worksharder996/watercolorbot-revival/sources/primary-sources.md

# Primary source index

Research date: 2026-11-08.

## Original WaterColorBot

- Main wiki: https://wiki.evilmadscientist.com/WaterColorBot
- Hardware reference design: https://wiki.evilmadscientist.com/WaterColorBot_Reference_Design
- Software overview: https://wiki.evilmadscientist.com/WaterColorBot_Software
- Inkscape workflow: https://wiki.evilmadscientist.com/Inkscape_and_WaterColorBot
- RoboPaint: https://wiki.evilmadscientist.com/RoboPaint
- RoboPaint RT: https://wiki.evilmadscientist.com/RoboPaint_RT
- Troubleshooting: https://wiki.evilmadscientist.com/WaterColorBot_Troubleshooting
- Paper: https://wiki.evilmadscientist.com/WaterColorBot_Paper
- Paints: https://wiki.evilmadscientist.com/WaterColorBot_Paints
- Writing implements: https://wiki.evilmadscientist.com/WaterColorBot_Writing_Implements

## Controller

- EBB main page: https://www.schmalzhaus.com/EBB/
- Current EBB commands: https://evil-mad.github.io/EggBot/ebb.html
- Legacy EBB 2.x commands: https://evil-mad.github.io/EggBot/ebb2.html
- EBB release notes: https://evil-mad.github.io/EggBot/EBBReleaseNotes.html
- EggBot/EBB firmware source: https://github.com/evil-mad/EggBot
- SparkFun EBB hardware: https://github.com/sparkfun/EiBotBoard

## Software

- wcb-ink: https://github.com/evil-mad/wcb-ink
- plotink: https://github.com/evil-mad/plotink
- RoboPaint: https://github.com/evil-mad/robopaint
- RoboPaint RT: https://github.com/evil-mad/robopaint-rt
- WaterColorBlocks: https://github.com/evil-mad/WaterColorBlocks
- CNCServer: https://github.com/techninja/cncserver
- CNCServer REST API: https://github.com/techninja/cncserver/blob/master/API.md
- Scratch API: https://github.com/techninja/cncserver/blob/master/scratch/SCRATCH.API.md
- RoboPaint remote-print API: https://github.com/evil-mad/robopaint-mode-remote/blob/master/API.md

## Current commercial reference

- Bantam Tools WaterColorBot: https://bantamtools.com/products/bantam-tools-watercolorbot
- Evil Mad Scientist/AxiDraw history: https://content.bantamtools.com/blog/a-look-back-part-2

## Integrity manifests

See the JSON and TSV files in this directory for downloaded-file hashes, retrieval timestamps, license scans, and fork results.
