worksharder996/watercolorbot-revival/hardware/reference-designs/v1/wcb_refdesign/readme.txt

Eggbot 2.0 refrence design.

The files here are:

* Bill of materials, CSV format
* 1/4" plywood chassis and pen-arm parts, Inkscape SVG
* 1/4" Poplar pen-arm part, Inkscape SVG
* 1/2" plywood parts
* 0.020" delrin part, Inkscape SVG
* 0.010" acetal copolymer, Inkscape SVG
