worksharder996/watercolorbot-revival/hardware/reference-designs/v2/WCBv2.0_r1/Solidworks/Winch3.SLDPRT

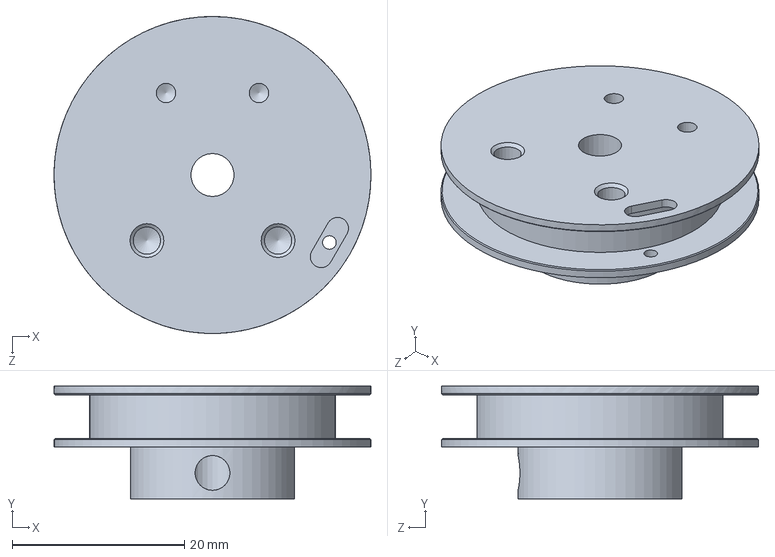
[picture p2: CAD file, 2026-11-08]
hardware/reference-designs/v2/WCBv2.0_r1/Solidworks/Winch3.SLDPRT
36.8 x 13.1 x 36.8 mm
