worksharder996/watercolorbot-revival/hardware/reference-designs/v2/WCBv2.0_r1/Solidworks/WCB-brushmount.SLDPRT

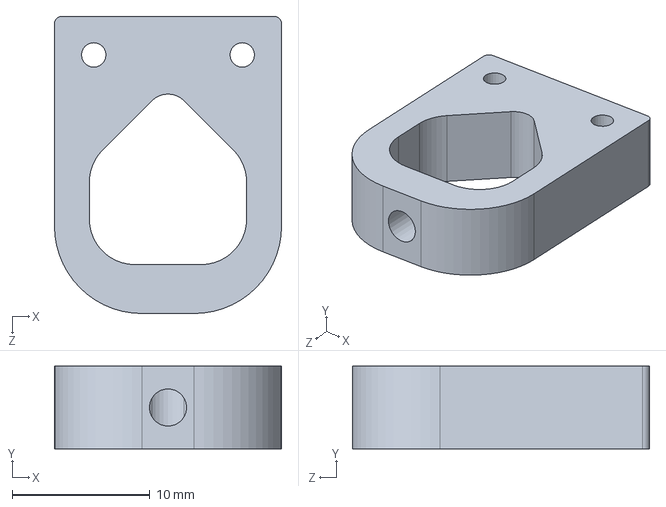
[picture p3: CAD file, 2026-11-08]
hardware/reference-designs/v2/WCBv2.0_r1/Solidworks/WCB-brushmount.SLDPRT
16.5 x 6.00 x 21.6 mm
