worksharder996/watercolorbot-revival/hardware/reference-designs/v2/WCBv2.0_r1/Solidworks/WCBC Bearing Mount.SLDPRT

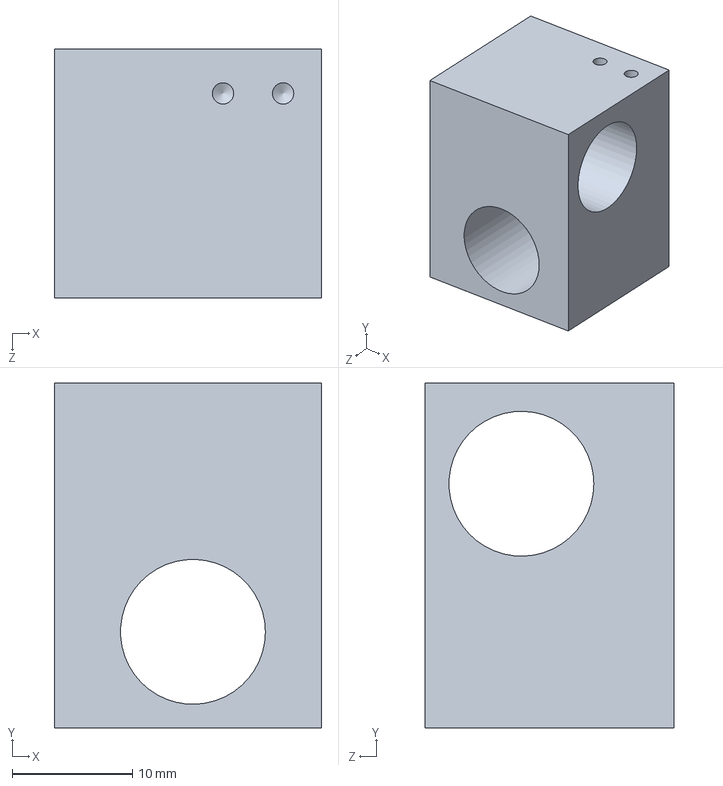
[picture p4: CAD file, 2026-11-08]
hardware/reference-designs/v2/WCBv2.0_r1/Solidworks/WCBC Bearing Mount.SLDPRT
22.2 x 28.7 x 20.7 mm
