worksharder996/watercolorbot-revival/hardware/reference-designs/v2/WCBv2.0_r1/Solidworks/shaft_6mm_long.SLDPRT

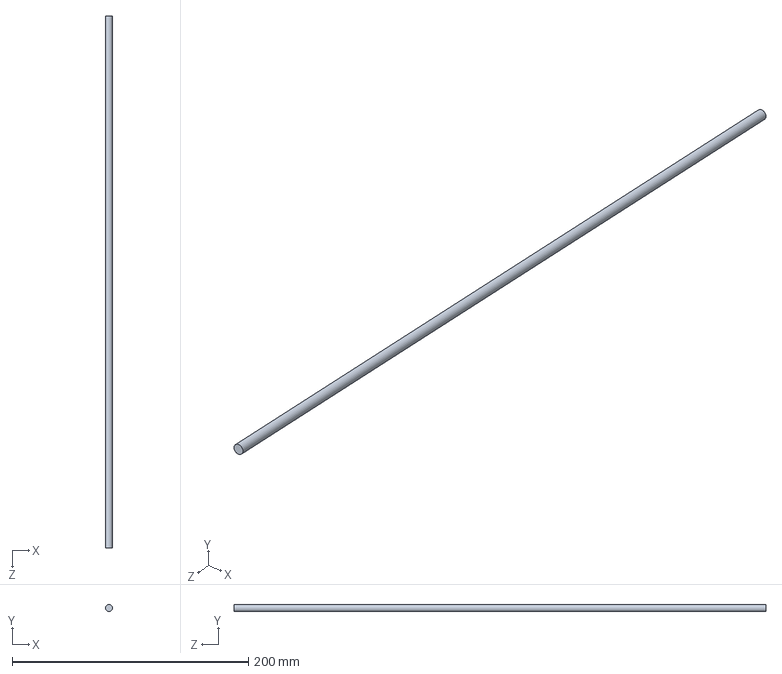
[picture p5: CAD file, 2026-11-08]
hardware/reference-designs/v2/WCBv2.0_r1/Solidworks/shaft_6mm_long.SLDPRT
6.00 x 6.00 x 450.0 mm
