worksharder996/watercolorbot-revival/hardware/reference-designs/v2/WCBv2.0_r1/Solidworks/Vertical Strut SM4.SLDPRT

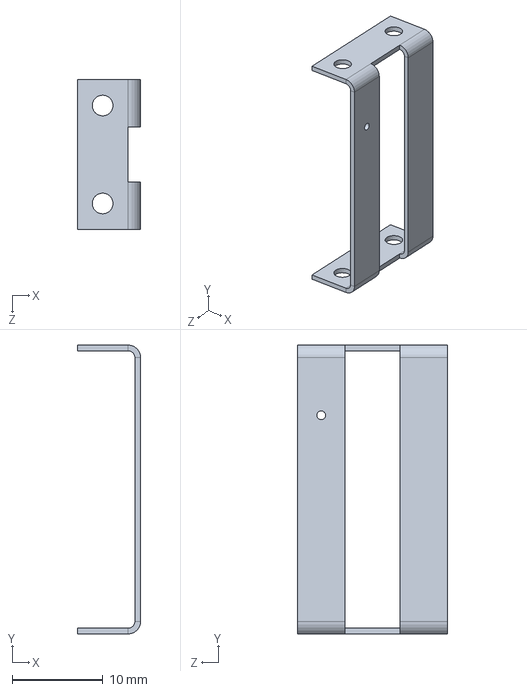
[picture p6: CAD file, 2026-11-08]
hardware/reference-designs/v2/WCBv2.0_r1/Solidworks/Vertical Strut SM4.SLDPRT
6.98 x 31.8 x 16.5 mm
