worksharder996/watercolorbot-revival/hardware/reference-designs/v2/WCBv2.0_r1/Solidworks/Carriage WrapPlate7.SLDPRT

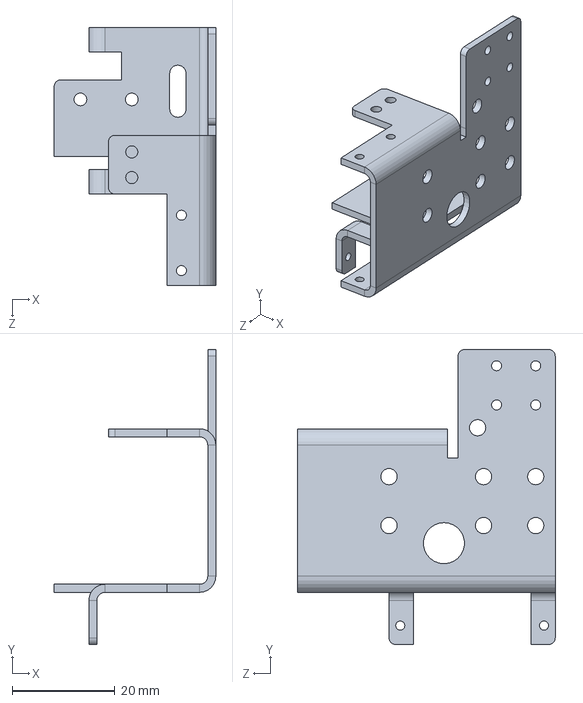
[picture p7: CAD file, 2026-11-08]
hardware/reference-designs/v2/WCBv2.0_r1/Solidworks/Carriage WrapPlate7.SLDPRT
31.5 x 57.5 x 50.2 mm
