worksharder996/watercolorbot-revival/hardware/reference-designs/v2/WCBv2.0_r1/Solidworks/WCB Hinge Washer.SLDPRT

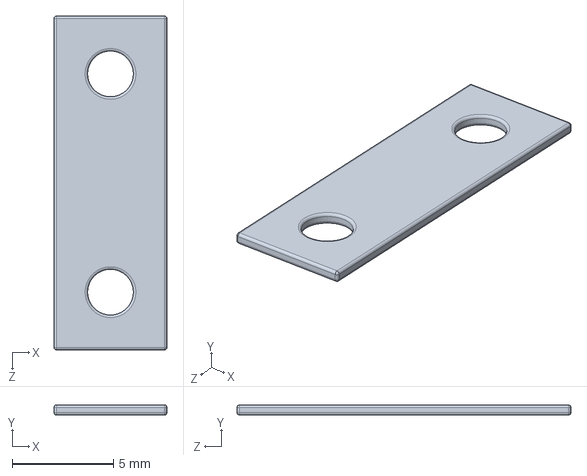
[picture p8: CAD file, 2026-11-08]
hardware/reference-designs/v2/WCBv2.0_r1/Solidworks/WCB Hinge Washer.SLDPRT
5.59 x 0.508 x 16.5 mm
