worksharder996/watercolorbot-revival/hardware/reference-designs/v2/WCBv2.0_r1/Solidworks/WCB_WINCH_BASE_61-0094A.PDF

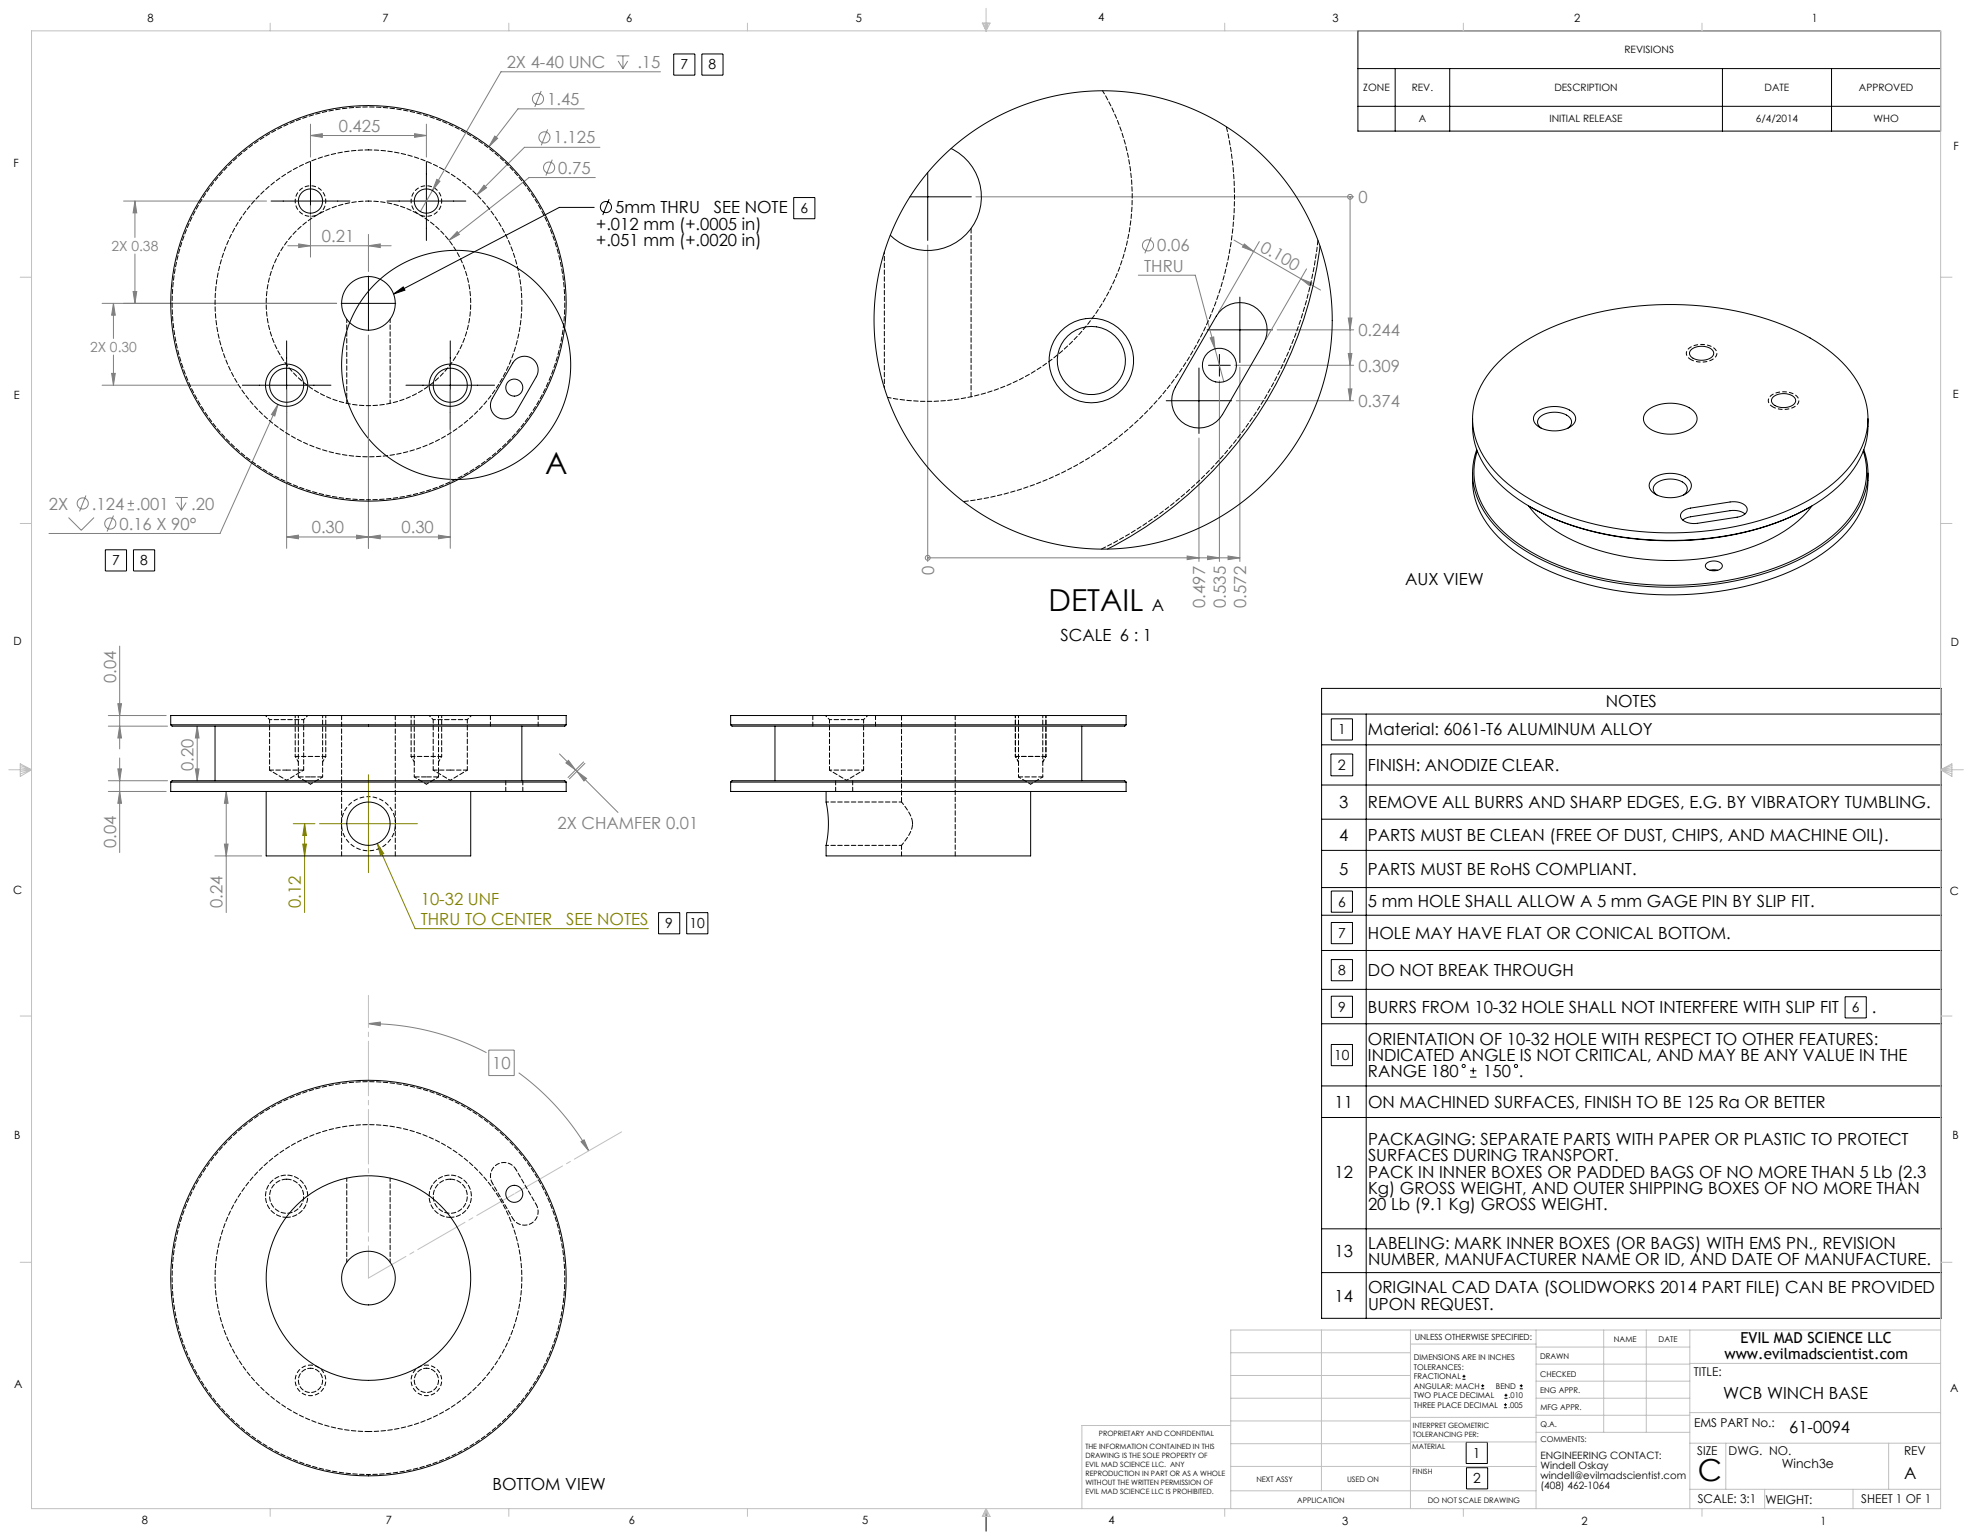
[picture p208: page 1]
2X CHAMFER 0.01; 2X 4-40 UNC; 5mm THRU SEE NOTE; AUX VIEW; DETAIL A; SCALE 6 : 1; BOTTOM VIEW; Material: 6061-T6 ALUMINUM ALLOY; FINISH: ANODIZE CLEAR.; HOLE MAY HAVE FLAT OR CONICAL BOTTOM.; DO NOT BREAK THROUGH; BURRS FROM 10-32 HOLE SHALL NOT INTERFERE WITH SLIP FIT; RANGE 180; SHEET 1 OF 1; SCALE: 3:1 WEIGHT:; DWG. NO.; REV; MFG APPR.; ENG APPR.; INTERPRET GEOMETRIC TOLERANCING PER:; ANGULAR: MACH; BEND; TWO PLACE DECIMAL; NEXT ASSY; USED ON; ENGINEERING CONTACT: Windell Oskay (408) 462-1064

ZONE | REV. | DESCRIPTION | DATE | APPROVED

A | INITIAL RELEASE | 6/4/2014 | WHO

3 | REMOVE ALL BURRS AND SHARP EDGES, E.G. BY VIBRATORY TUMBLING.
4 | PARTS MUST BE CLEAN (FREE OF DUST, CHIPS, AND MACHINE OIL).
5 | PARTS MUST BE RoHS COMPLIANT.
6 | 5 mm HOLE SHALL ALLOW A 5 mm GAGE PIN BY SLIP FIT.

10-32 UNF
THRU TO CENTER SEE NOTES

ORIENTATION OF 10-32 HOLE WITH RESPECT TO OTHER FEATURES: INDICATED ANGLE IS NOT CRITICAL, AND MAY BE ANY VALUE IN THE

11 | ON MACHINED SURFACES, FINISH TO BE 125 Ra OR BETTER
12 | PACKAGING: SEPARATE PARTS WITH PAPER OR PLASTIC TO PROTECT SURFACES DURING TRANSPORT. PACK IN INNER BOXES OR PADDED BAGS OF NO MORE THAN 5 Lb (2.3 Kg) GROSS WEIGHT, AND OUTER SHIPPING BOXES OF NO MORE THAN 20 Lb (9.1 Kg) GROSS WEIGHT.

13 | LABELING: MARK INNER BOXES (OR BAGS) WITH EMS PN., REVISION NUMBER, MANUFACTURER NAME OR ID, AND DATE OF MANUFACTURE.

14 | ORIGINAL CAD DATA (SOLIDWORKS 2014 PART FILE) CAN BE PROVIDED UPON REQUEST.

EVIL MAD SCIENCE LLC
www.evilmadscientist.com
TITLE:
WCB WINCH BASE

UNLESS OTHERWISE SPECIFIED:

DIMENSIONS ARE IN INCHES
TOLERANCES:
FRACTIONAL
THREE PLACE DECIMAL .005

EMS PART No.:
SIZE

PROPRIETARY AND CONFIDENTIAL
THE INFORMATION CONTAINED IN THIS
DRAWING IS THE SOLE PROPERTY OF
EVIL MAD SCIENCE LLC. ANY
REPRODUCTION IN PART OR AS A WHOLE
WITHOUT THE WRITTEN PERMISSION OF
EVIL MAD SCIENCE LLC IS PROHIBITED.

DO NOT SCALE DRAWING
