worksharder996/watercolorbot-revival/hardware/reference-designs/v2/WCBv2.0_r1/Solidworks/WCBC BearingMount.PDF

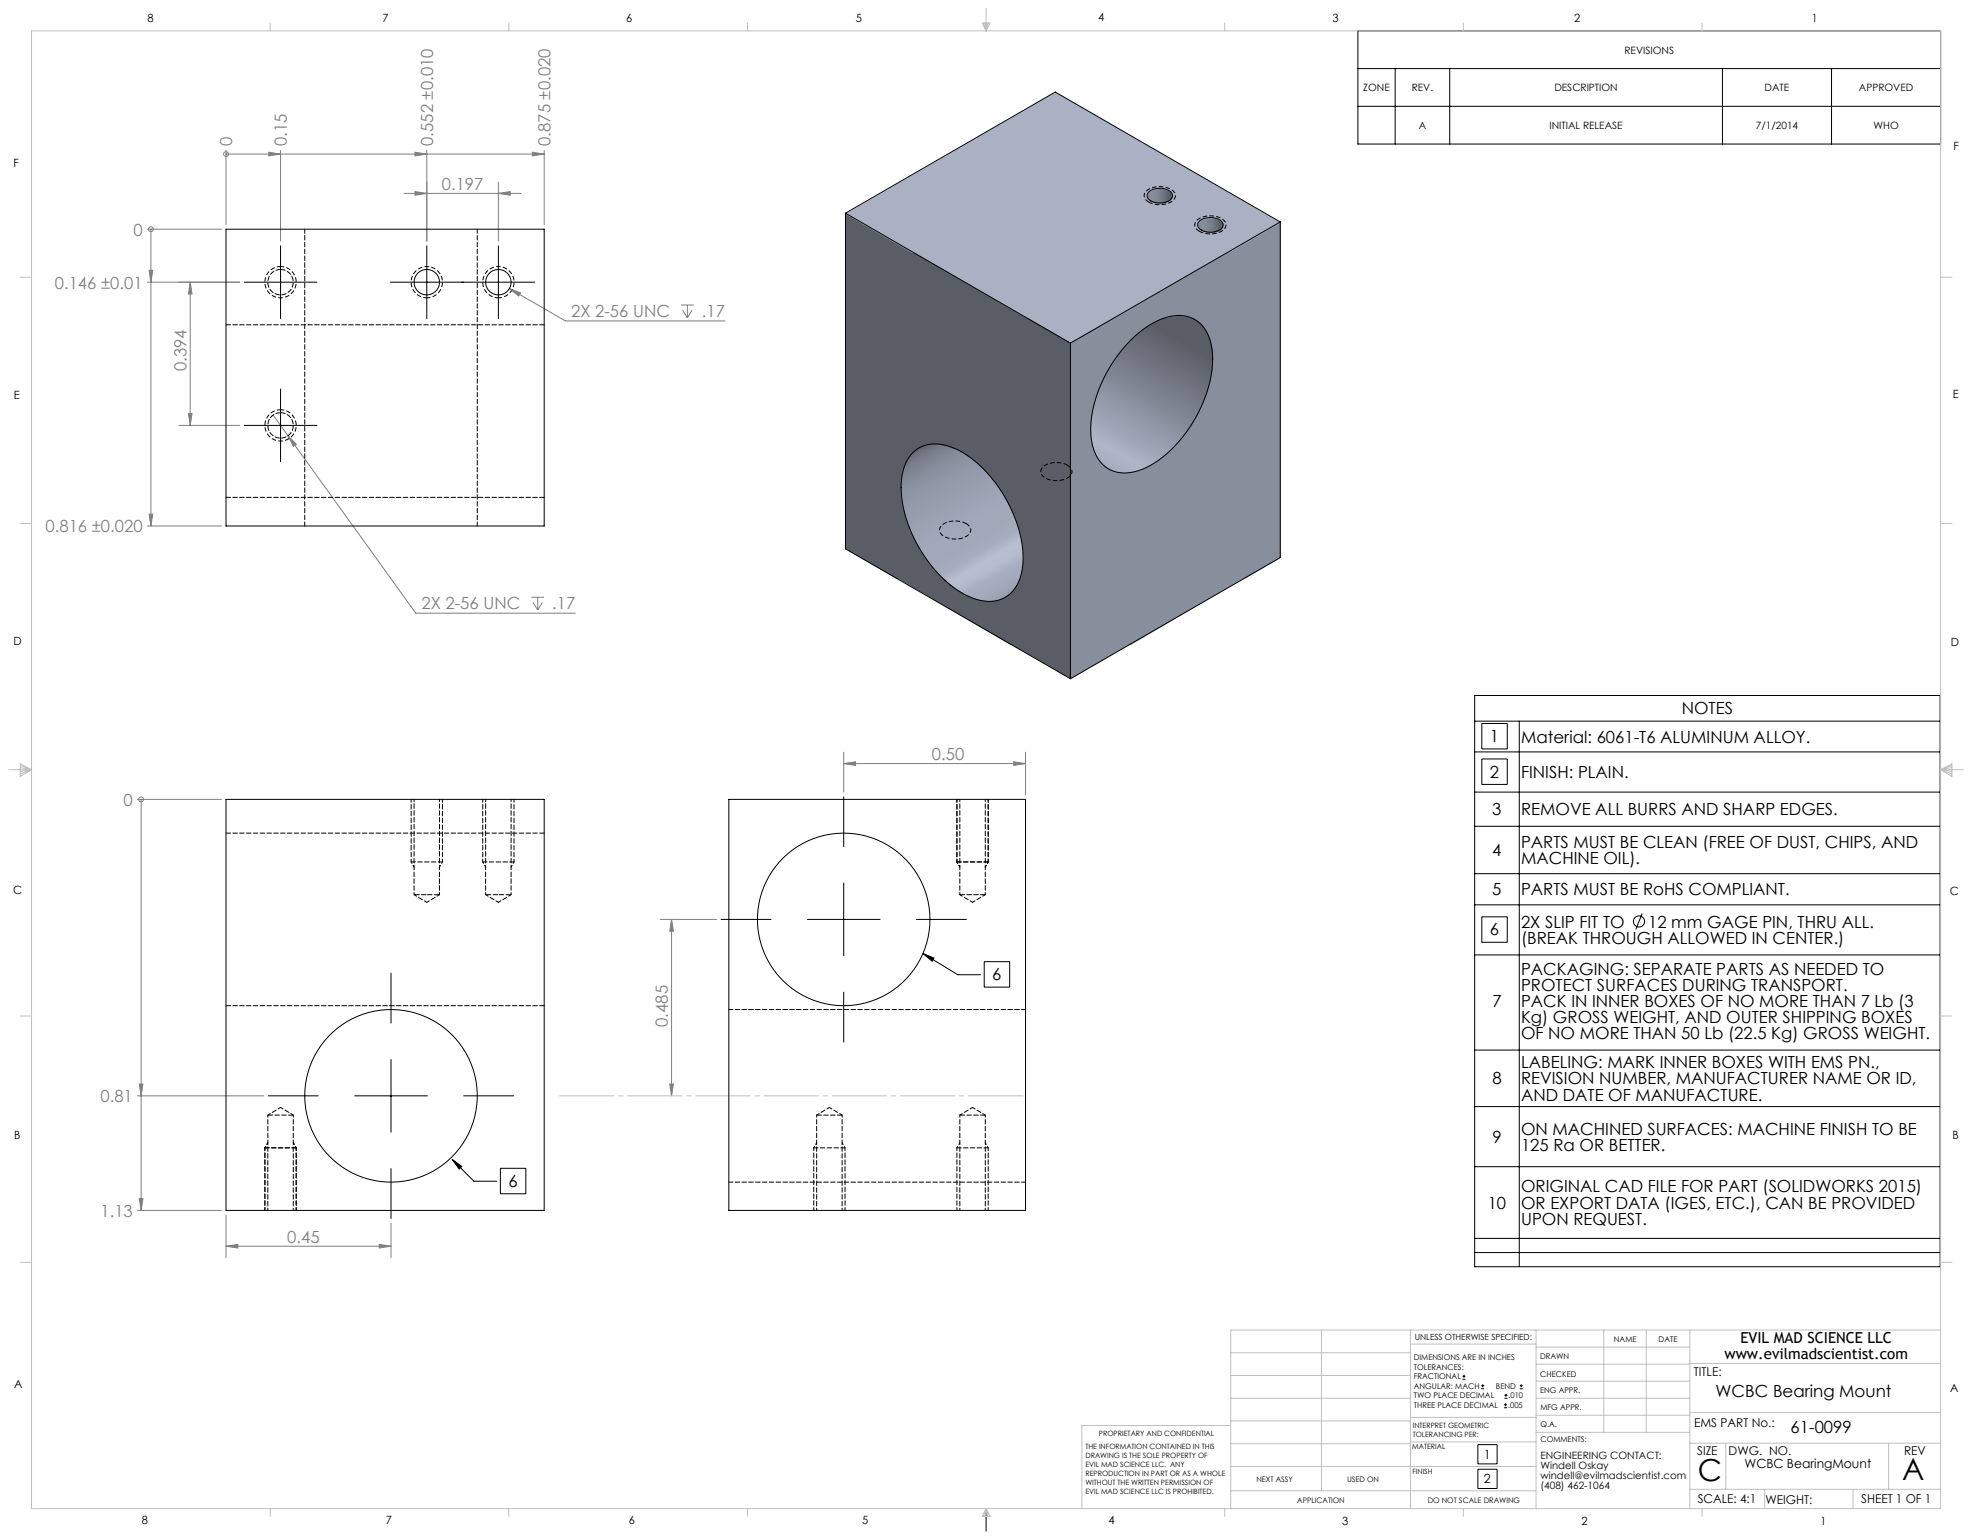
[picture p209: page 1]
2X 2-56 UNC; Material: 6061-T6 ALUMINUM ALLOY.; FINISH: PLAIN.; 2X SLIP FIT TO 12 mm GAGE PIN, THRU ALL.; SHEET 1 OF 1; SCALE: 4:1 WEIGHT:; DWG. NO.; REV; MFG APPR.; ENG APPR.; INTERPRET GEOMETRIC TOLERANCING PER:; ANGULAR: MACH; BEND; TWO PLACE DECIMAL; NEXT ASSY; USED ON; ENGINEERING CONTACT: Windell Oskay (408) 462-1064

ZONE | REV. | DESCRIPTION | DATE | APPROVED

A | INITIAL RELEASE | 7/1/2014 | WHO

3 | REMOVE ALL BURRS AND SHARP EDGES.
4 | PARTS MUST BE CLEAN (FREE OF DUST, CHIPS, AND MACHINE OIL).

5 | PARTS MUST BE RoHS COMPLIANT.

(BREAK THROUGH ALLOWED IN CENTER.)

7 | PACKAGING: SEPARATE PARTS AS NEEDED TO PROTECT SURFACES DURING TRANSPORT. PACK IN INNER BOXES OF NO MORE THAN 7 Lb (3 Kg) GROSS WEIGHT, AND OUTER SHIPPING BOXES OF NO MORE THAN 50 Lb (22.5 Kg) GROSS WEIGHT.

8 | LABELING: MARK INNER BOXES WITH EMS PN., REVISION NUMBER, MANUFACTURER NAME OR ID, AND DATE OF MANUFACTURE.

9 | ON MACHINED SURFACES: MACHINE FINISH TO BE 125 Ra OR BETTER.

ORIGINAL CAD FILE FOR PART (SOLIDWORKS 2015)
UPON REQUEST.

OR EXPORT DATA (IGES, ETC.), CAN BE PROVIDED

EVIL MAD SCIENCE LLC
www.evilmadscientist.com
TITLE:
WCBC Bearing Mount
WCBC BearingMount

UNLESS OTHERWISE SPECIFIED:

DIMENSIONS ARE IN INCHES
TOLERANCES:
FRACTIONAL
THREE PLACE DECIMAL .005

EMS PART No.:
SIZE

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

DO NOT SCALE DRAWING
