worksharder996/watercolorbot-revival/hardware/reference-designs/v2/WCBv2.0_r1/Solidworks/WCBC BrushMount.PDF

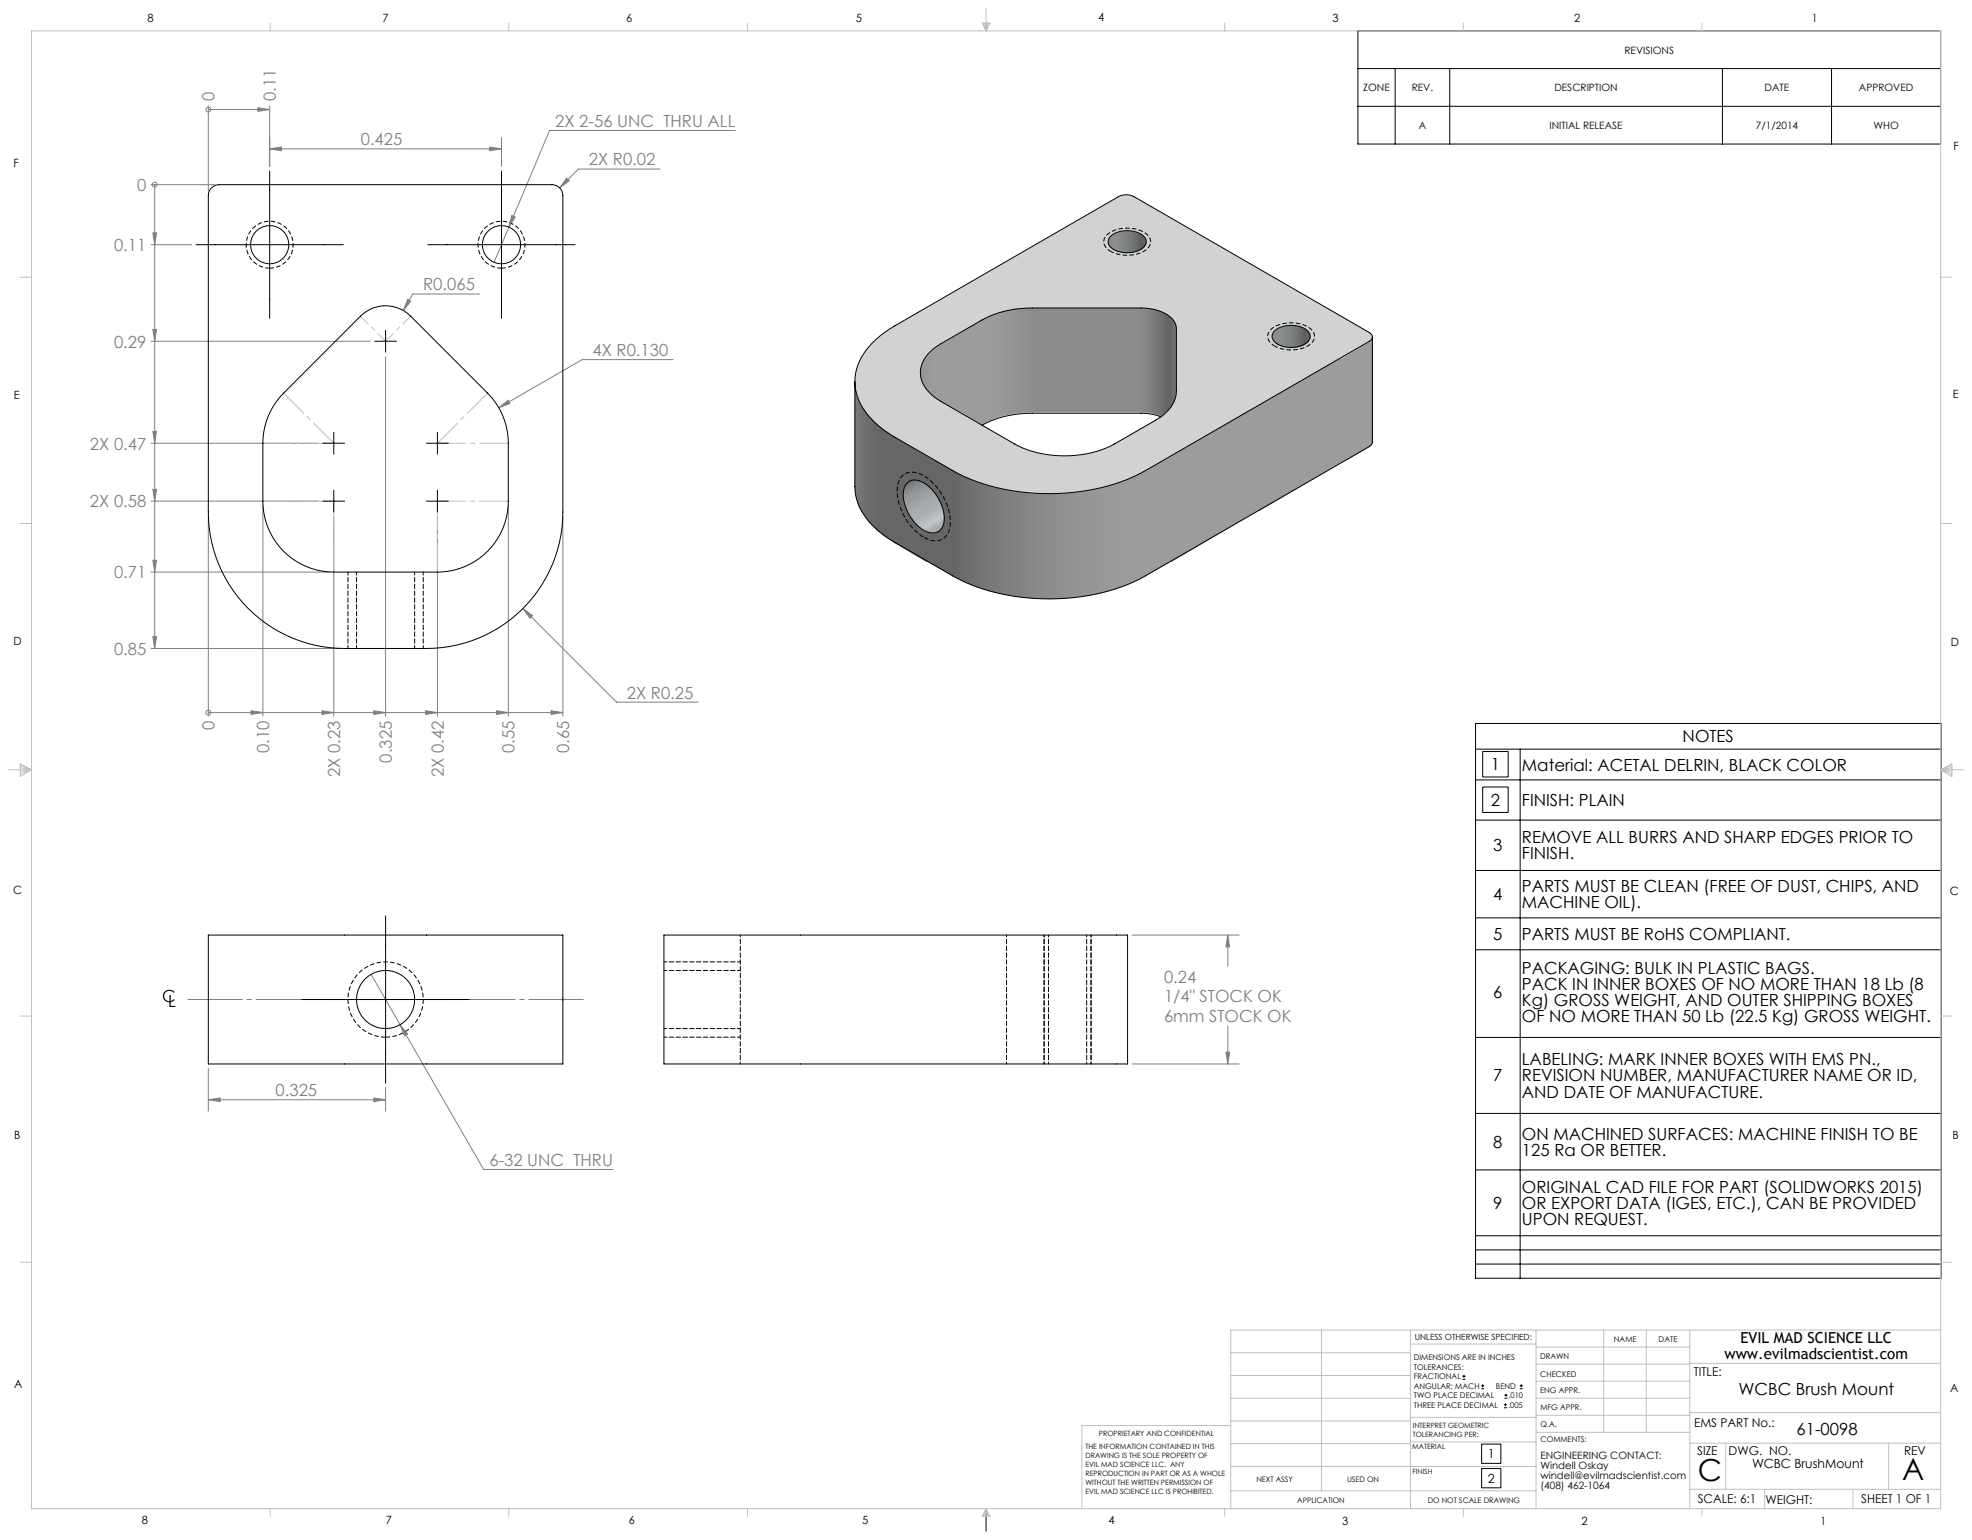
[picture p210: page 1]
6-32 UNC THRU; 1/4" STOCK OK 6mm STOCK OK; Material: ACETAL DELRIN, BLACK COLOR; FINISH: PLAIN; WCBC BrushMount; SHEET 1 OF 1; SCALE: 6:1 WEIGHT:; DWG. NO.; REV; MFG APPR.; ENG APPR.; INTERPRET GEOMETRIC TOLERANCING PER:; ANGULAR: MACH; BEND; TWO PLACE DECIMAL; NEXT ASSY; USED ON; ENGINEERING CONTACT: Windell Oskay (408) 462-1064; EMS PART No.:

ZONE | REV. | DESCRIPTION | DATE | APPROVED

2X 2-56 UNC THRU ALL

A | INITIAL RELEASE | 7/1/2014 | WHO

3 | REMOVE ALL BURRS AND SHARP EDGES PRIOR TO FINISH.

4 | PARTS MUST BE CLEAN (FREE OF DUST, CHIPS, AND MACHINE OIL).

5 | PARTS MUST BE RoHS COMPLIANT.
6 | PACKAGING: BULK IN PLASTIC BAGS. PACK IN INNER BOXES OF NO MORE THAN 18 Lb (8 Kg) GROSS WEIGHT, AND OUTER SHIPPING BOXES OF NO MORE THAN 50 Lb (22.5 Kg) GROSS WEIGHT.

7 | LABELING: MARK INNER BOXES WITH EMS PN., REVISION NUMBER, MANUFACTURER NAME OR ID, AND DATE OF MANUFACTURE.

8 | ON MACHINED SURFACES: MACHINE FINISH TO BE 125 Ra OR BETTER.

9 | ORIGINAL CAD FILE FOR PART (SOLIDWORKS 2015) OR EXPORT DATA (IGES, ETC.), CAN BE PROVIDED UPON REQUEST.

EVIL MAD SCIENCE LLC
www.evilmadscientist.com
TITLE:
WCBC Brush Mount

UNLESS OTHERWISE SPECIFIED:

DIMENSIONS ARE IN INCHES
TOLERANCES:
FRACTIONAL
THREE PLACE DECIMAL .005

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

DO NOT SCALE DRAWING
