worksharder996/watercolorbot-revival/hardware/reference-designs/v2/WCBv2.0_r1/Solidworks/WCBC Vertical Strut B.PDF

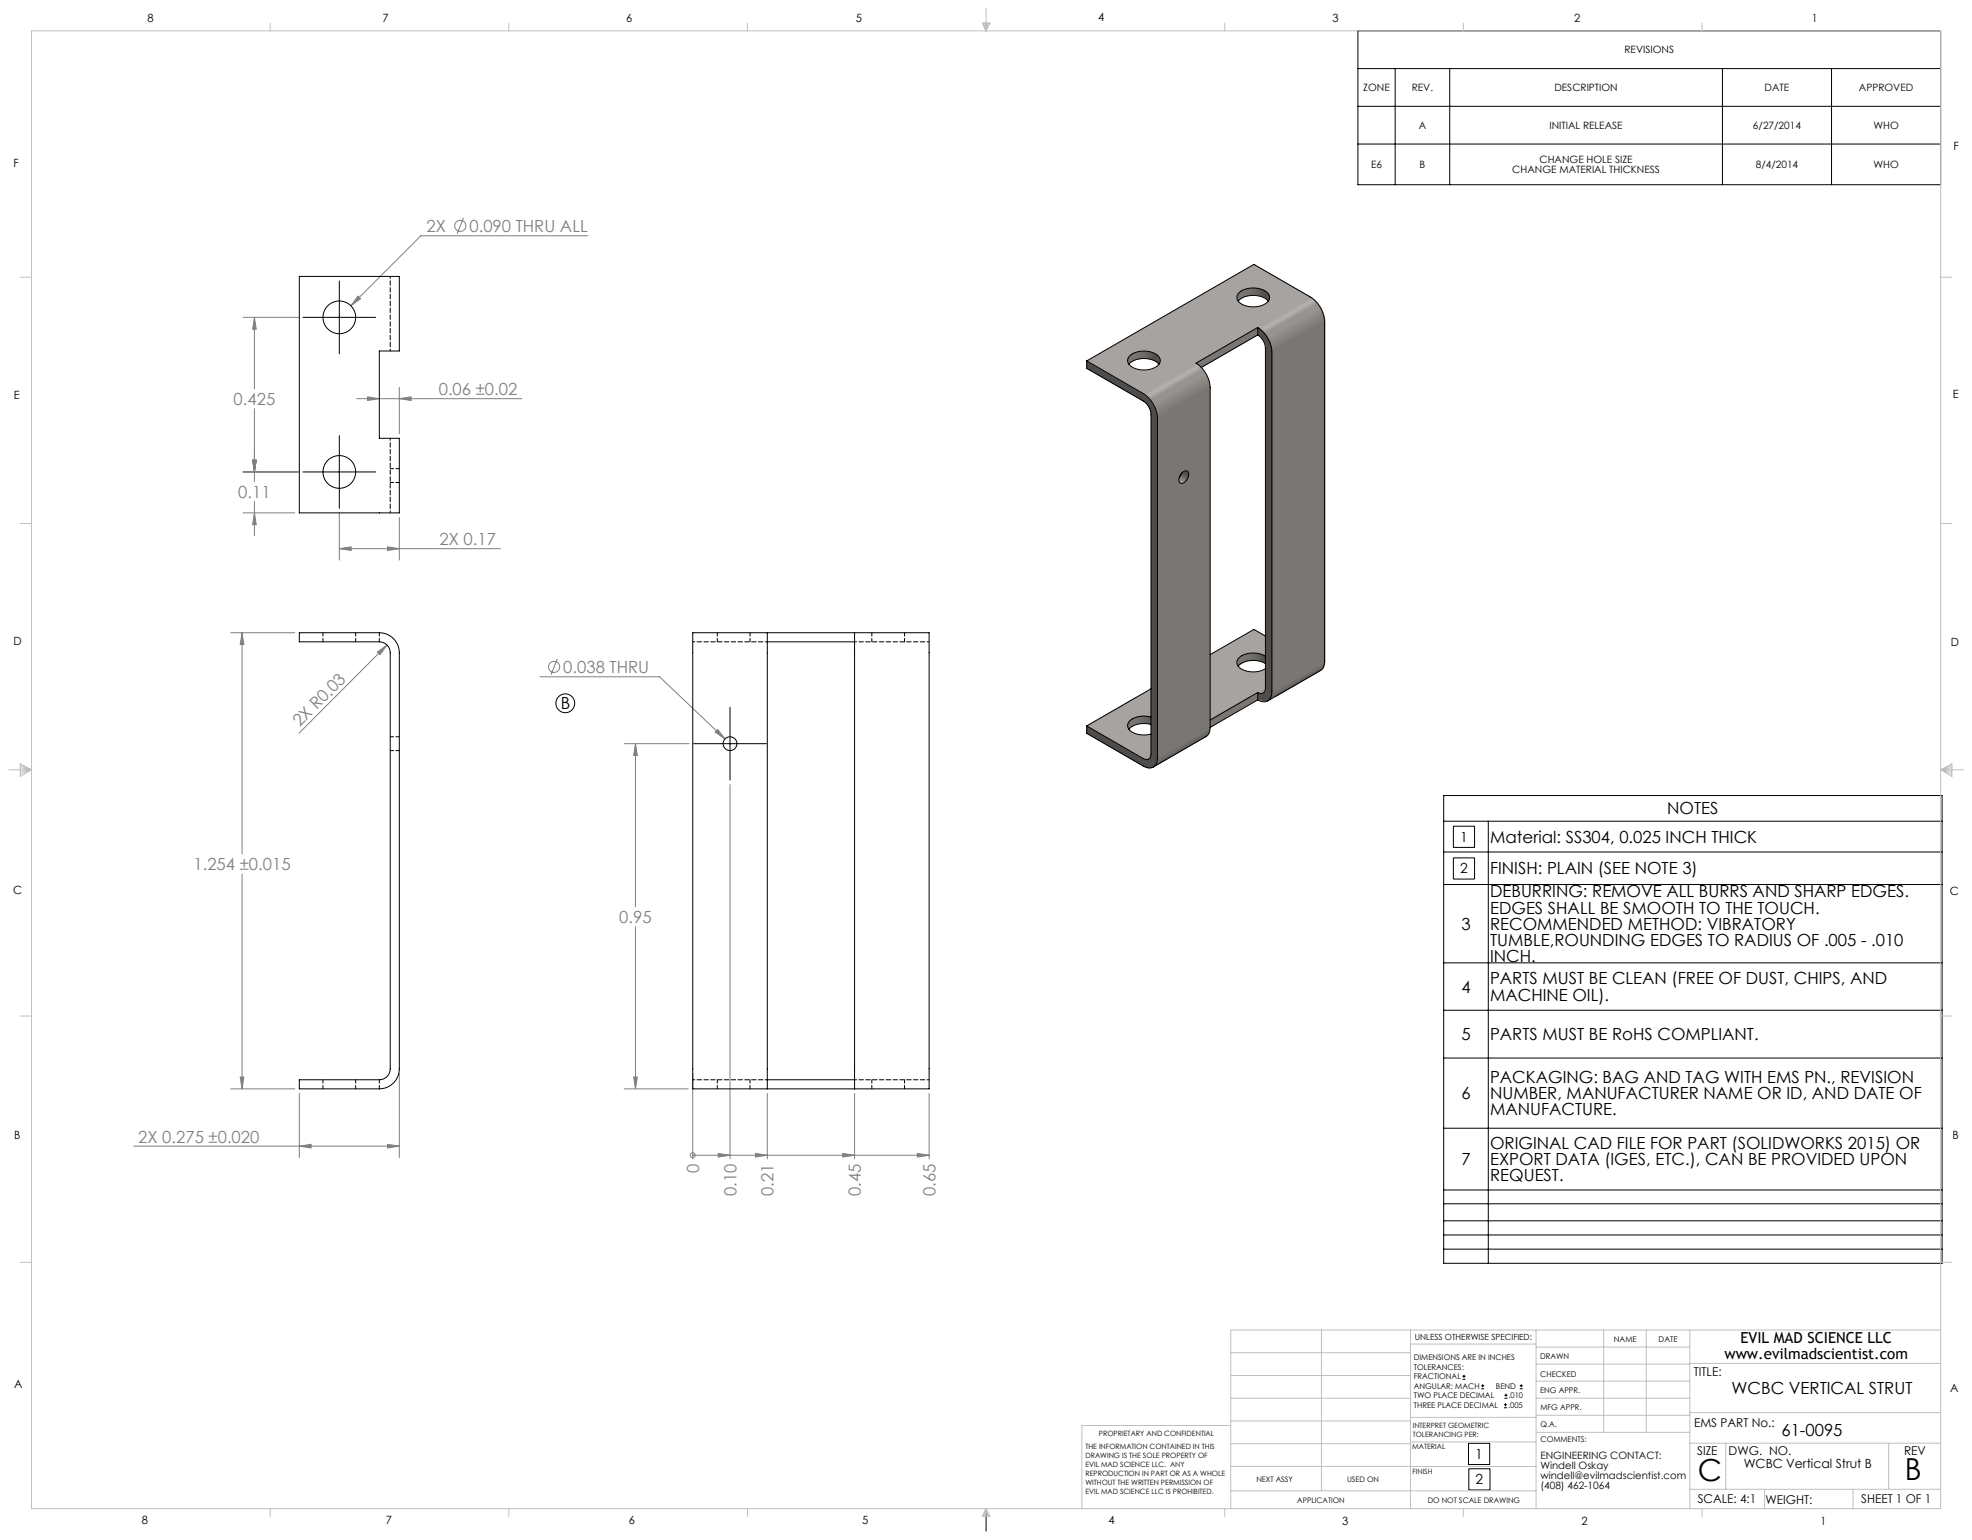
[picture p211: page 1]
2X 0.090 THRU ALL; 0.038 THRU; Material: SS304, 0.025 INCH THICK; FINISH: PLAIN (SEE NOTE 3); SHEET 1 OF 1; SCALE: 4:1 WEIGHT:; DWG. NO.; REV; MFG APPR.; ENG APPR.; INTERPRET GEOMETRIC TOLERANCING PER:; ANGULAR: MACH; BEND; TWO PLACE DECIMAL; NEXT ASSY; USED ON; ENGINEERING CONTACT: Windell Oskay (408) 462-1064

ZONE | REV. | DESCRIPTION | DATE | APPROVED

A | INITIAL RELEASE | 6/27/2014 | WHO

E6 | B | CHANGE HOLE SIZE CHANGE MATERIAL THICKNESS | 8/4/2014 | WHO

3 | DEBURRING: REMOVE ALL BURRS AND SHARP EDGES. EDGES SHALL BE SMOOTH TO THE TOUCH. RECOMMENDED METHOD: VIBRATORY TUMBLE,ROUNDING EDGES TO RADIUS OF .005 - .010 INCH.

4 | PARTS MUST BE CLEAN (FREE OF DUST, CHIPS, AND MACHINE OIL).

5 | PARTS MUST BE RoHS COMPLIANT.
6 | PACKAGING: BAG AND TAG WITH EMS PN., REVISION NUMBER, MANUFACTURER NAME OR ID, AND DATE OF MANUFACTURE.

7 | ORIGINAL CAD FILE FOR PART (SOLIDWORKS 2015) OR EXPORT DATA (IGES, ETC.), CAN BE PROVIDED UPON REQUEST.

EVIL MAD SCIENCE LLC
www.evilmadscientist.com
TITLE:
WCBC VERTICAL STRUT

UNLESS OTHERWISE SPECIFIED:

DIMENSIONS ARE IN INCHES
TOLERANCES:
FRACTIONAL
THREE PLACE DECIMAL .005

EMS PART No.:
SIZE
WCBC Vertical Strut B

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

DO NOT SCALE DRAWING
