worksharder996/watercolorbot-revival/hardware/reference-designs/v2/WCBv2.0_r1/Solidworks/WCBC_Wrap_Plate_61-0096B.PDF

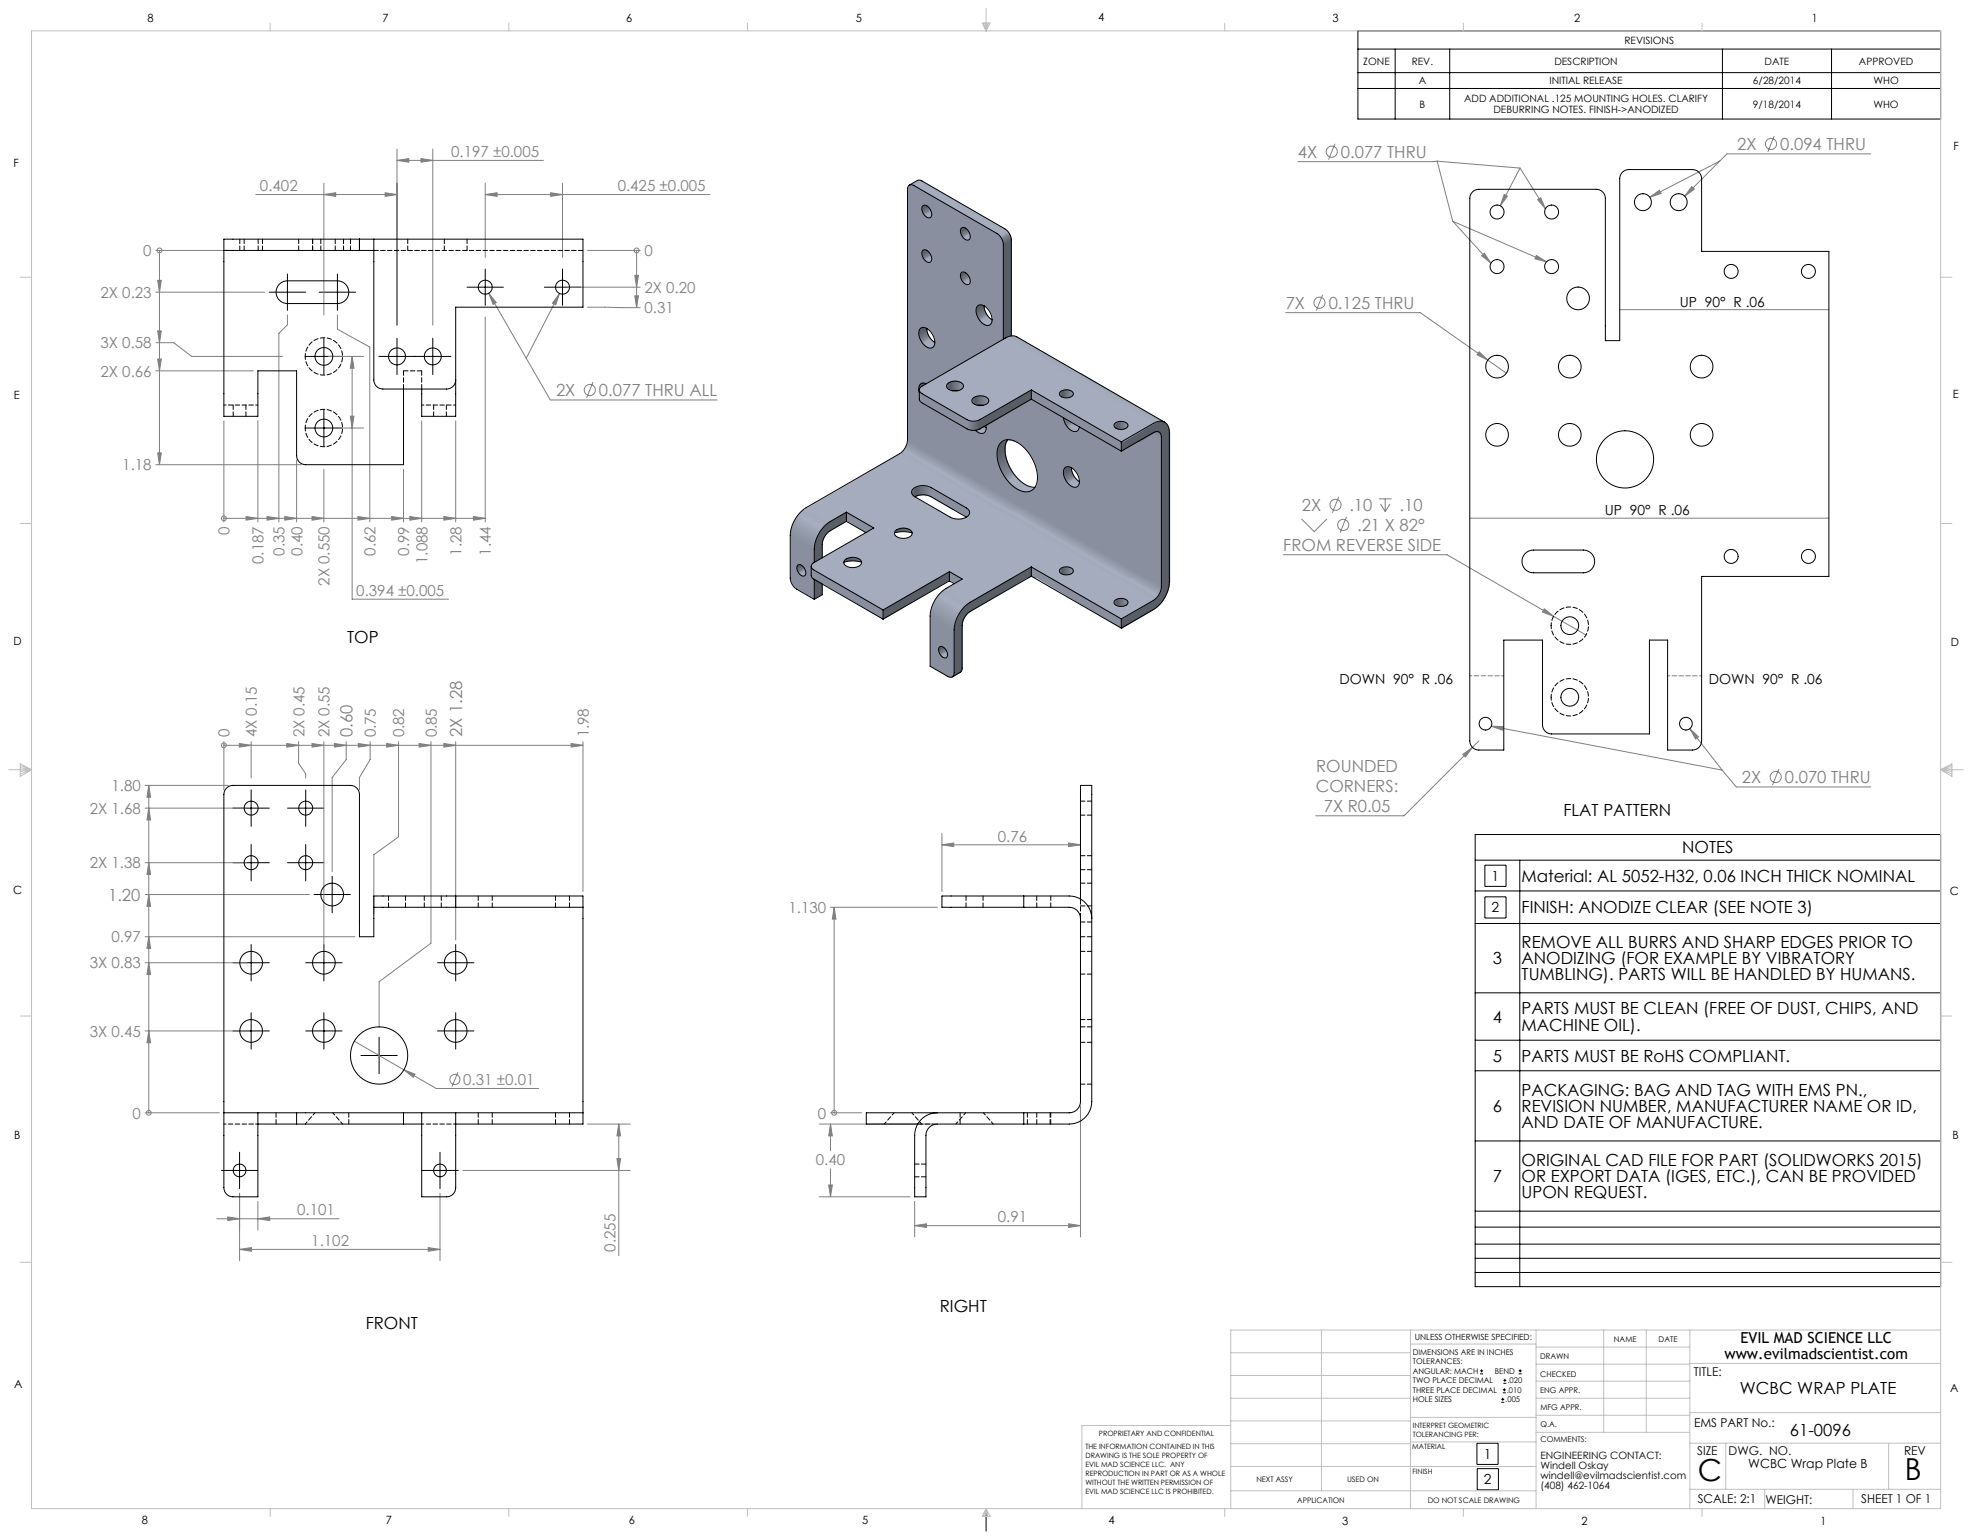
[picture p212: page 1]
2X 0.077 THRU ALL; 2X 0.070 THRU; 4X 0.077 THRU; 7X 0.125 THRU; 2X 0.094 THRU; FLAT PATTERN; DOWN 90° R .06; Material: AL 5052-H32, 0.06 INCH THICK NOMINAL; FINISH: ANODIZE CLEAR (SEE NOTE 3); SHEET 1 OF 1; SCALE: 2:1 WEIGHT:; DWG. NO.; REV; MFG APPR.; ENG APPR.; INTERPRET GEOMETRIC TOLERANCING PER:; ANGULAR: MACH; BEND; TWO PLACE DECIMAL; HOLE SIZES; NEXT ASSY; USED ON

ZONE | REV. | DESCRIPTION | DATE | APPROVED

A | INITIAL RELEASE | 6/28/2014 | WHO
B | ADD ADDITIONAL .125 MOUNTING HOLES. CLARIFY DEBURRING NOTES. FINISH->ANODIZED | 9/18/2014 | WHO

FROM REVERSE SIDE

3 | REMOVE ALL BURRS AND SHARP EDGES PRIOR TO ANODIZING (FOR EXAMPLE BY VIBRATORY TUMBLING). PARTS WILL BE HANDLED BY HUMANS.

4 | PARTS MUST BE CLEAN (FREE OF DUST, CHIPS, AND MACHINE OIL).

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

EVIL MAD SCIENCE LLC
www.evilmadscientist.com
TITLE:
WCBC WRAP PLATE

UNLESS OTHERWISE SPECIFIED:
DIMENSIONS ARE IN INCHES
TOLERANCES:
THREE PLACE DECIMAL .010

EMS PART No.:
SIZE
WCBC Wrap Plate B

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

ENGINEERING CONTACT:
Windell Oskay
windell@evilmadscientist.com

DO NOT SCALE DRAWING
