worksharder996/watercolorbot-revival/hardware/reference-designs/v2/WCBv2.0_r1/WCB-brushmount.PDF

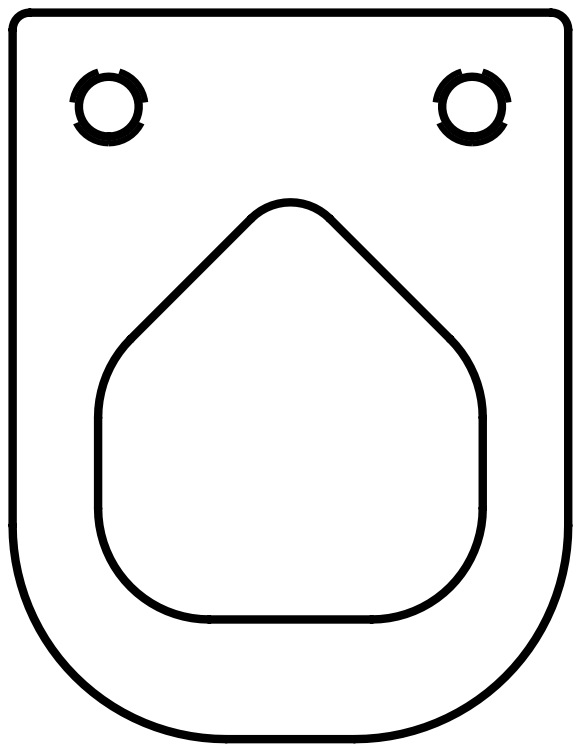
[picture p213: page 1]
