worksharder996/watercolorbot-revival/(list of files, drawings)

Other design files:
hardware/reference-designs/v2/WCBv2.0_r1/flex_pcb/flexure_b.pcb
