worksharder996/watercolorbot-revival/(commit log)

2026-11-08 Create WaterColorBot revival research archive
    [Carriage WrapPlate7.SLDPRT, Vertical Strut SM4.SLDPRT, WBC_BOM1.csv, WCB Hinge Washer.SLDPRT, WCB-brushmount.SLDPRT, WCBC Bearing Mount.SLDPRT, Winch3.SLDPRT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]
2026-11-09 Verify archive and extend preserved controller sources
    [fork-manifest.tsv, repository-license-scan.tsv]
